jhon02078/enjambre-robots-vision/docs/README.md

# Documentación y material multimedia

Índice de diagramas, informe, fotografías y demostraciones del proyecto.

## Diagramas

- [Arquitectura del sistema](diagramas/Arquitectura%20del%20Sistema.png)
- [Máquina de estados](diagramas/Máquina%20de%20Estados.png)

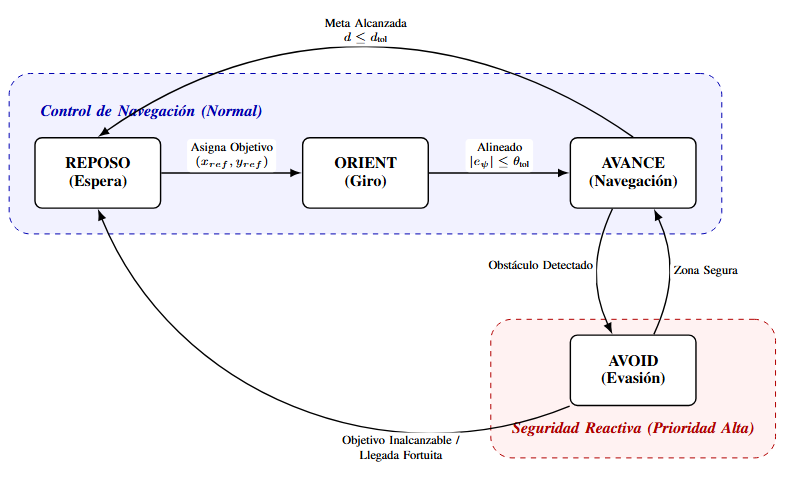
[picture p12: docs/diagramas/Máquina de Estados.png]
Máquina de estados


## Informe

- [Informe del proyecto](informe/Informe.pdf)

El informe conserva el contexto académico y de diseño. Para instrucciones de
ejecución actualizadas use el [README principal](../README.md), porque el
software ha evolucionado después de algunas capturas y documentos.

## Imágenes

### Interfaz

- [Captura de interfaz 1](media/fotos/captura_interfaz_1.jpg)
- [Captura de interfaz 2](media/fotos/captura_interfaz_2.jpg)

### Robots

- [Robot 1](media/fotos/robot_imagen_1.jpg)
- [Robot 2](media/fotos/robot_imagen_2.jpg)
- [Robot 3](media/fotos/robot_imagen_3.jpg)
- [Robot 4](media/fotos/robot_imagen_4.jpg)
- [Robot 5](media/fotos/robot_imagen_5.jpg)

Los números de estas fotografías son un índice de archivo y no necesariamente
coinciden con los IDs ArUco actuales.

## Animación

- [Demostración de funcionamiento](media/gifs/demo_funcionamiento.gif)

Demostración

## Videos

- [Video 1](media/videos/video_funcionamiento_1.mp4)
- [Video 2](media/videos/video_funcionamiento_2.mp4)
- [Video 3](media/videos/video_funcionamiento_3.mp4)
- [Video 4](media/videos/video_funcionamiento_4.mp4)
- [Video 5](media/videos/video_funcionamiento_5.mp4)
- [Video 6](media/videos/video_funcionamiento_6.mp4)
- [Video 7](media/videos/video_funcionamiento_7.mp4)
- [Video 8](media/videos/video_funcionamiento_8.mp4)
- [Video 9](media/videos/video_funcionamiento_9.mp4)

## Mantenimiento

- Use nombres descriptivos para nuevos archivos.
- Comprima videos antes de añadirlos al repositorio.
- No guarde aquí resultados experimentales generados automáticamente.
- Actualice este índice cuando agregue o retire material.
- Evite archivos temporales creados por editores o sincronización en la nube.
