jhon02078/enjambre-robots-vision/docs/media/fotos/captura_interfaz_1.jpg

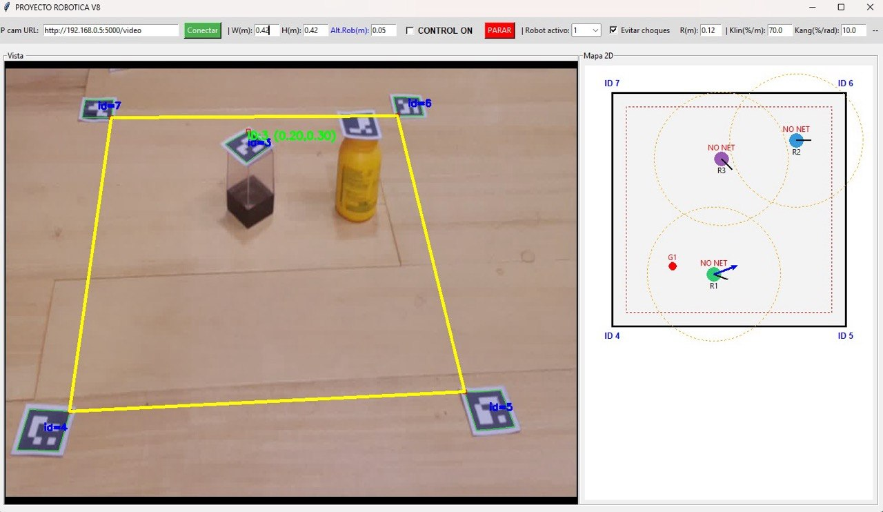
docs/media/fotos/captura_interfaz_1.jpg
