jhon02078/enjambre-robots-vision/docs/media/fotos/robot_imagen_1.jpg

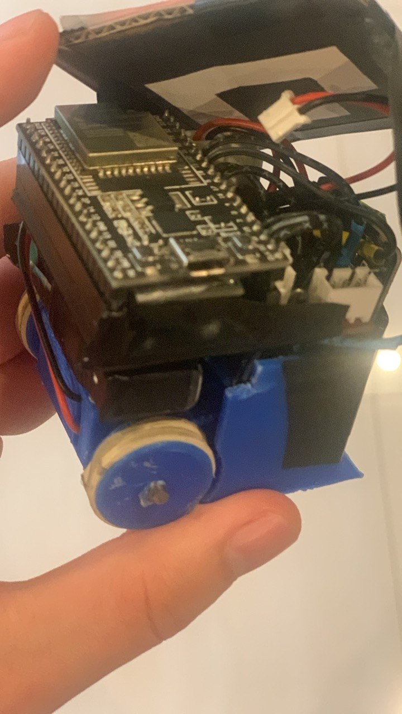
docs/media/fotos/robot_imagen_1.jpg
