jhon02078/enjambre-robots-vision/docs/media/fotos/robot_imagen_2.jpg

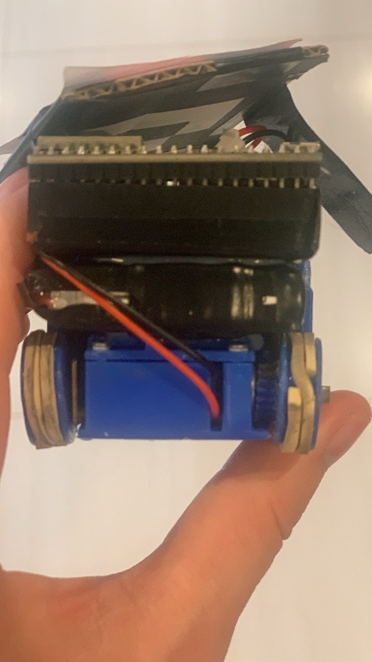
docs/media/fotos/robot_imagen_2.jpg
