jhon02078/enjambre-robots-vision/docs/media/fotos/robot_imagen_3.jpg

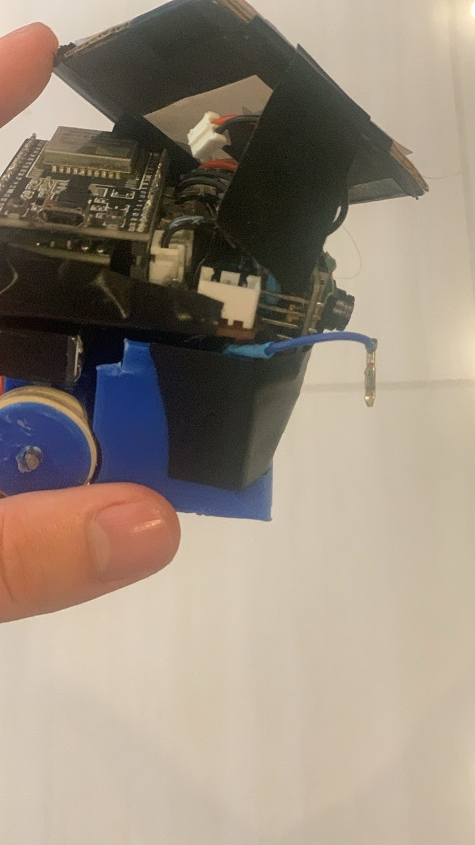
docs/media/fotos/robot_imagen_3.jpg
