jhon02078/enjambre-robots-vision/docs/media/fotos/robot_imagen_4.jpg

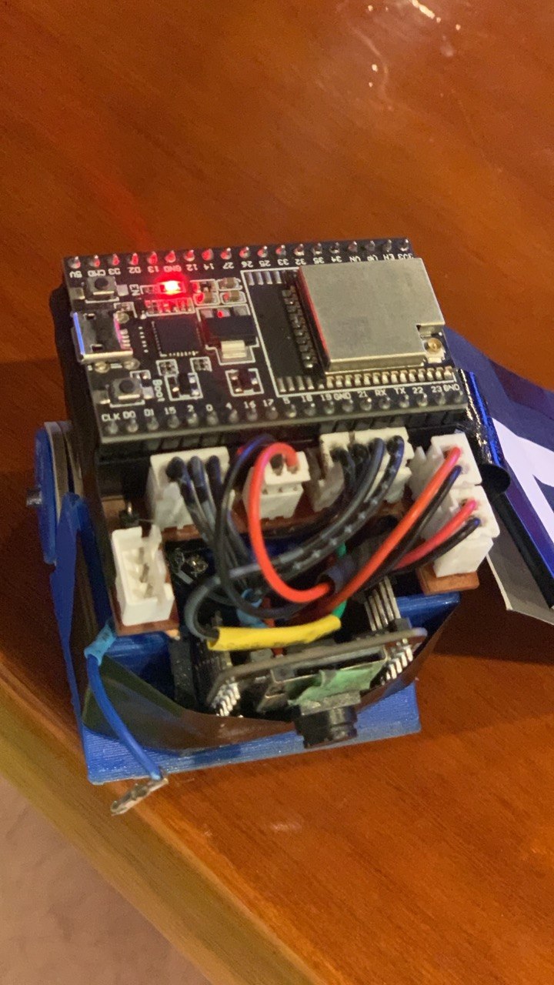
docs/media/fotos/robot_imagen_4.jpg
