jhon02078/enjambre-robots-vision/hardware/pcb/imagenes/pcb_montada.png

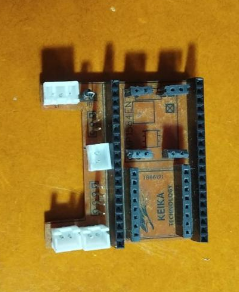
hardware/pcb/imagenes/pcb_montada.png
