jhon02078/enjambre-robots-vision/hardware/cad/Engrane.STL

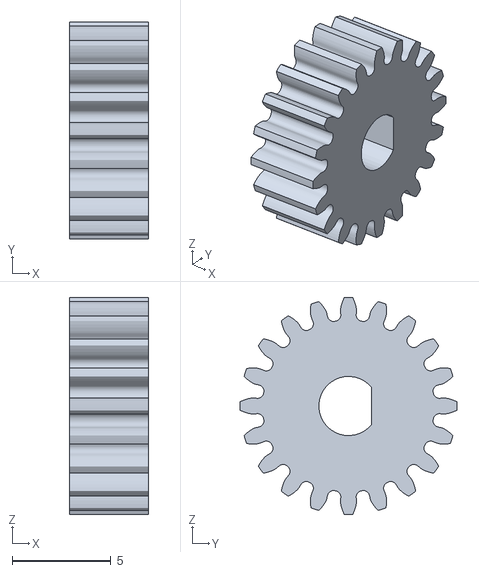
[picture p20: CAD file, 2026-04-19]
hardware/cad/Engrane.STL
4.00 x 11.0 x 11.0
