jhon02078/enjambre-robots-vision/hardware/cad/Llanta.STL

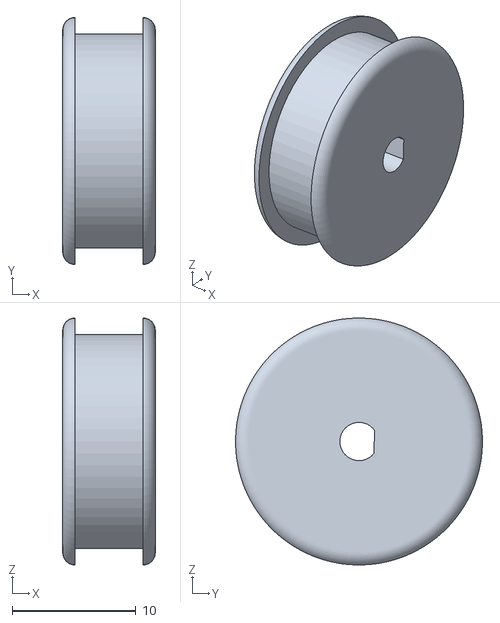
[picture p21: CAD file, 2026-04-19]
hardware/cad/Llanta.STL
7.50 x 20.0 x 20.0
