jhon02078/enjambre-robots-vision/hardware/cad/BaseYTorre.STL

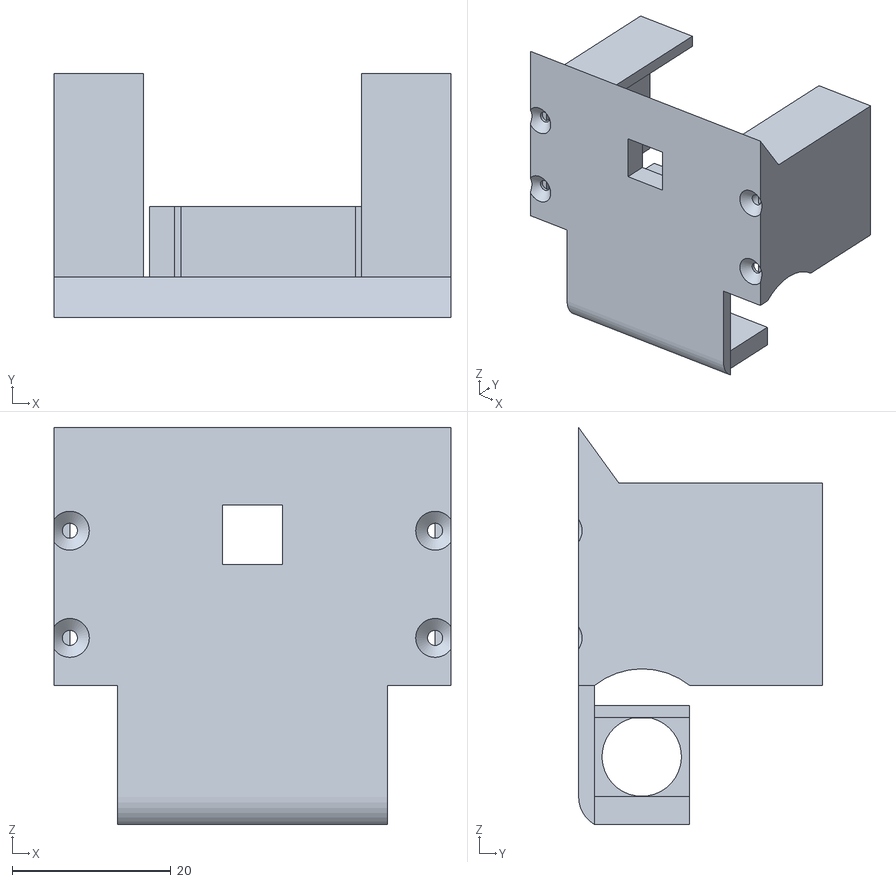
[picture p22: CAD file, 2026-04-19]
hardware/cad/BaseYTorre.STL
50.0 x 30.7 x 50.0
