jhon02078/enjambre-robots-vision/hardware/cad/TapaMotor.STL

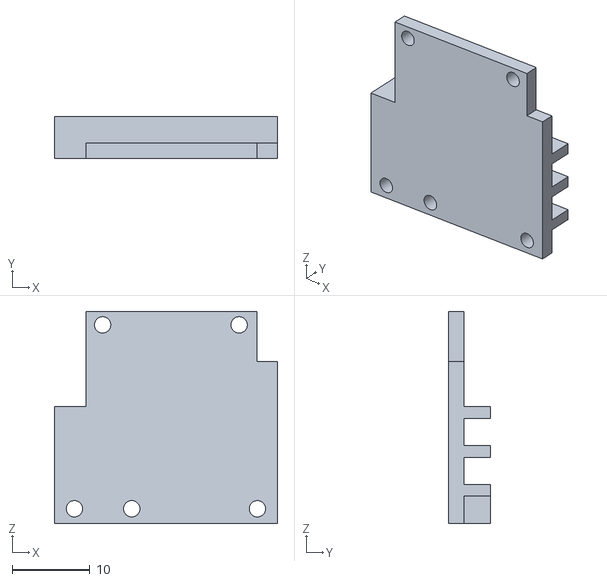
[picture p23: CAD file, 2026-04-19]
hardware/cad/TapaMotor.STL
28.6 x 5.45 x 27.2
