jhon02078/enjambre-robots-vision/hardware/pcb/imagenes/pcb_fabricada.png

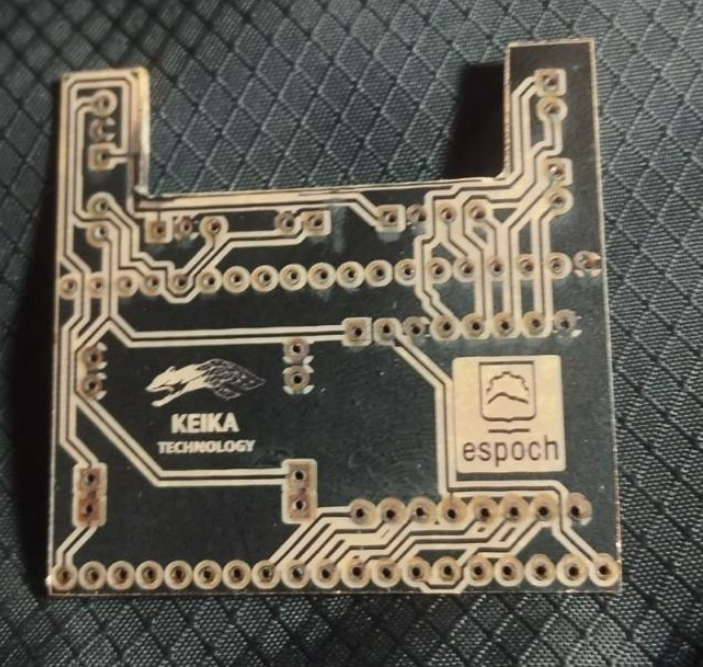
hardware/pcb/imagenes/pcb_fabricada.png
