jhon02078/enjambre-robots-vision/paper/configuracion_publica/intrinsic_validation.csv

timestamp_utc | point | robot_id | physical_x_m | physical_y_m | off_raw_x_m | off_raw_y_m | off_raw_error_m | on_raw_x_m | on_raw_y_m | on_raw_error_m | off_parallax_x_m | off_parallax_y_m | off_parallax_error_m | on_parallax_x_m | on_parallax_y_m | on_parallax_error_m | off_detection_rate_pct | on_detection_rate_pct | off_camera_pose_m | on_camera_pose_m
2026-08-17T20:43:53+00:00 | VIS02_P1_CENTER | 2 | 0.585 | 0.607 | 0.6005092859268188 | 0.6703889966011047 | 0.06525873765293573 | 0.600368082523346 | 0.6764200925827026 | 0.07110082428942284 | 0.597416768574244 | 0.6212414131137666 | 0.018894284567119668 | 0.5968815682409258 | 0.6237664454789384 | 0.02054958291211752 | 100.0 | 92.22222222222223 | [0.5417298450872645, -0.2637585429739723, 1.7106289383162996] | [0.5390367580783869, -0.2498109944414803, 1.5831913346457793]
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
