jhon02078/enjambre-robots-vision/paper/resultados/final_80/all_runs.csv

run_dir | scenario | condition | replicate | controller_mode | requested_delay_ms | duration_s | task_duration_s | task_completed | trial_valid | outcome | stop_reason | minimum_pairwise_distance_m | collision_threshold_episodes | ack_rate_pct | rtt_mean_ms | rtt_p95_ms | actual_delay_mean_ms | actual_delay_p95_ms | vision_processing_mean_ms | frame_wait_mean_ms | homography_valid_rate_pct | detection_rate_pct | path_length_m | distance_rmse_m | heading_mae_deg | control_effort_abs_pct_s | state_transitions | angular_sign_changes | targets_reached
paper/resultados/raw/cruce_2/20260817_205636_cruce_2_proposed_final_r01 | cruce_2 | proposed_final | 1 | apf_fsm | 0.0 | 28.856315699988045 | 27.464995999995153 | 1.0 | 1.0 | success | completed | 0.12743352517238718 | 0.0 | 0.0 | nan | nan | 0.0 | 0.0 | 64.41555347916184 | 17.9508591307398 | 100.0 | 98.26086956521739 | 2.0498846157886463 | 0.5569388890249637 | 28.467928377019565 | 3107.514645397867 | 6.0 | 31.0 | 2.0
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
