jhon02078/enjambre-robots-vision/paper/resultados/final_80/group_statistics.csv

scenario | condition | controller_mode | requested_delay_ms | n | task_duration_s_mean | task_duration_s_std | task_duration_s_ci95_low | task_duration_s_ci95_high | task_completed_mean | task_completed_std | task_completed_ci95_low | task_completed_ci95_high | minimum_pairwise_distance_m_mean | minimum_pairwise_distance_m_std | minimum_pairwise_distance_m_ci95_low | minimum_pairwise_distance_m_ci95_high | collision_threshold_episodes_mean | collision_threshold_episodes_std | collision_threshold_episodes_ci95_low | collision_threshold_episodes_ci95_high | detection_rate_pct_mean | detection_rate_pct_std | detection_rate_pct_ci95_low | detection_rate_pct_ci95_high | path_length_m_mean | path_length_m_std | path_length_m_ci95_low | path_length_m_ci95_high | distance_rmse_m_mean | distance_rmse_m_std | distance_rmse_m_ci95_low | distance_rmse_m_ci95_high | heading_mae_deg_mean | heading_mae_deg_std | heading_mae_deg_ci95_low | heading_mae_deg_ci95_high | control_effort_abs_pct_s_mean | control_effort_abs_pct_s_std | control_effort_abs_pct_s_ci95_low | control_effort_abs_pct_s_ci95_high | state_transitions_mean | state_transitions_std | state_transitions_ci95_low |
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
