jhon02078/enjambre-robots-vision/paper/resultados/final_80/statistical_tests.csv

family | scenario | metric | test | statistic | p_value | n_a | n_b | effect
controller_success | cruce_2 | task_completed | fisher_exact_two_sided | 13.5 | 0.05727554179566563 | 10 | 10 | 0.5
controller_metric | cruce_2 | task_duration_s | mann_whitney_two_sided | 31.0 | 0.050349650349650346 | 9 | 4 | 0.7222222222222222
controller_metric | cruce_2 | minimum_pairwise_distance_m | mann_whitney_two_sided | 54.0 | 0.7913367801006604 | 10 | 10 | 0.08
controller_metric | cruce_2 | heading_mae_deg | mann_whitney_two_sided | 15.0 | 0.009108496398030963 | 10 | 10 | -0.7
controller_metric | cruce_2 | control_effort_abs_pct_s | mann_whitney_two_sided | 82.0 | 0.017257456083119765 | 10 | 10 | 0.64
controller_metric | cruce_2 | angular_sign_changes | mann_whitney_two_sided | 97.5 | 0.00036205898501509104 | 10 | 10 | 0.95
controller_success | cruce_2_perpendicular | task_completed | fisher_exact_two_sided | inf | 1.0 | 10 | 10 | 0.09999999999999998
controller_metric | cruce_2_perpendicular | task_duration_s | mann_whitney_two_sided | 90.0 | 0.0002797002701866865 | 10 | 9 | 1.0
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
