jhon02078/enjambre-robots-vision/paper/resultados/raw/cruce_2/20260817_205636_cruce_2_proposed_final_r01/control.csv

wall_time_iso | t_wall | t_perf | session_elapsed_s | cycle_id | robot_id | state | previous_state | x | y | yaw | pose_age_ms | waypoint_x | waypoint_y | final_goal_x | final_goal_y | distance_error | desired_heading | angle_error | u_att_x | u_att_y | u_rep_x | u_rep_y | u_res_x | u_res_y | repulsion_norm | align_factor | linear_cmd | angular_cmd | left_cmd | right_cmd | controller_mode | avoid_enabled | requested_delay_ms | jitter_ms
2026-08-18T01:56:36.623+00:00 | 1787018196.623529 | 178009.0424996 | 0.2710949000029359 | 108 | 2 | ORIENT | ORIENT | 0.9916435438883312 | 0.612898096502323 | 0.15385420916602616 | 359.63988304138184 | 0.2 | 0.625 | 0.2 | 0.625 | 0.7917360397558918 | 3.1263067833978133 | 2.972452574231787 | -0.9998831748962402 | 0.01528527494519949 | 0.0 | 0.0 | -0.9998831748962402 | 0.01528527494519949 | 0.0 | 0.0 | 0 | 35.0 | -35 | 35 | apf_fsm | 1 | 0.0 | 0.0
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
