jhon02078/enjambre-robots-vision/paper/resultados/raw/cruce_2/20260817_205636_cruce_2_proposed_final_r01/events.csv

wall_time_iso | t_wall | t_perf | session_elapsed_s | event | robot_id | payload_json
2026-08-18T01:56:36.525+00:00 | 1787018196.5251293 | 178008.9405909 | 0.16918619998614304 | session_start |  | {"scenario":"cruce_2","condition":"proposed_final","replicate":1,"controller_mode":"apf_fsm","requested_delay_ms":0.0,"jitter_ms":0.0,"collision_threshold_m":0.12,"homography_mode":"estabilizada","camera_calibration_enabled":true,"camera_calibration_path":"paper/configuracion_publica/camera_calibration.json","localization_alignment_enabled":true,"localization_alignment":{"version":1,"method":"translation_bias_after_parallax","enabled":true,"offset_x_m":-0.01286124999999999,"offset_y_m":-0.011444499999999982,"marker_height_m":0.09,"workspace_width_m":1.2,"workspace_height_m":1.2,"calibration_points":["P_03_03","P_09_03","P_09_09","P_03_09"],"calibration_rmse_m":0.006934283808548666,"calibration_max_error_m":0.011660421596687702,"path":"paper/configuracion_publica/localization_alignment.json"},"parallax_enabled":true,"pose_filter_enabled":true,"robot_ids":[1,2,3,10],"workspace_width_m":1.2,"workspace_height_m":1.2,"workspace_marker_size_m":{"4":0.056,"5":0.056,"6":0.071,"7":0.071},"robot_ma
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
