jhon02078/enjambre-robots-vision/paper/resultados/final_80/controller_comparison.png

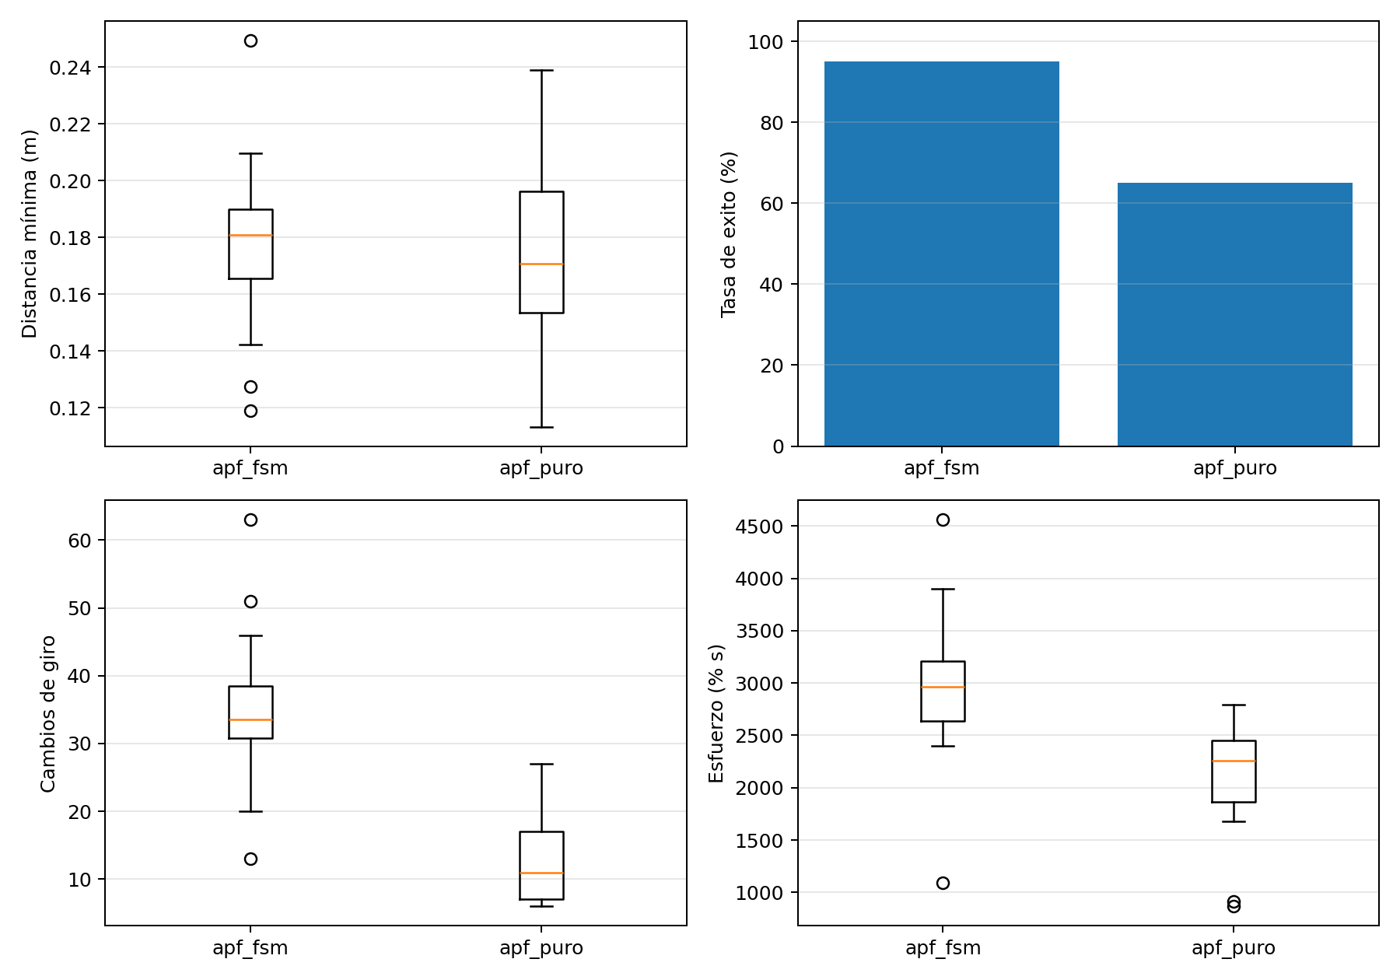
paper/resultados/final_80/controller_comparison.png
