jhon02078/enjambre-robots-vision/paper/resultados/final_80/latency_sweep.png

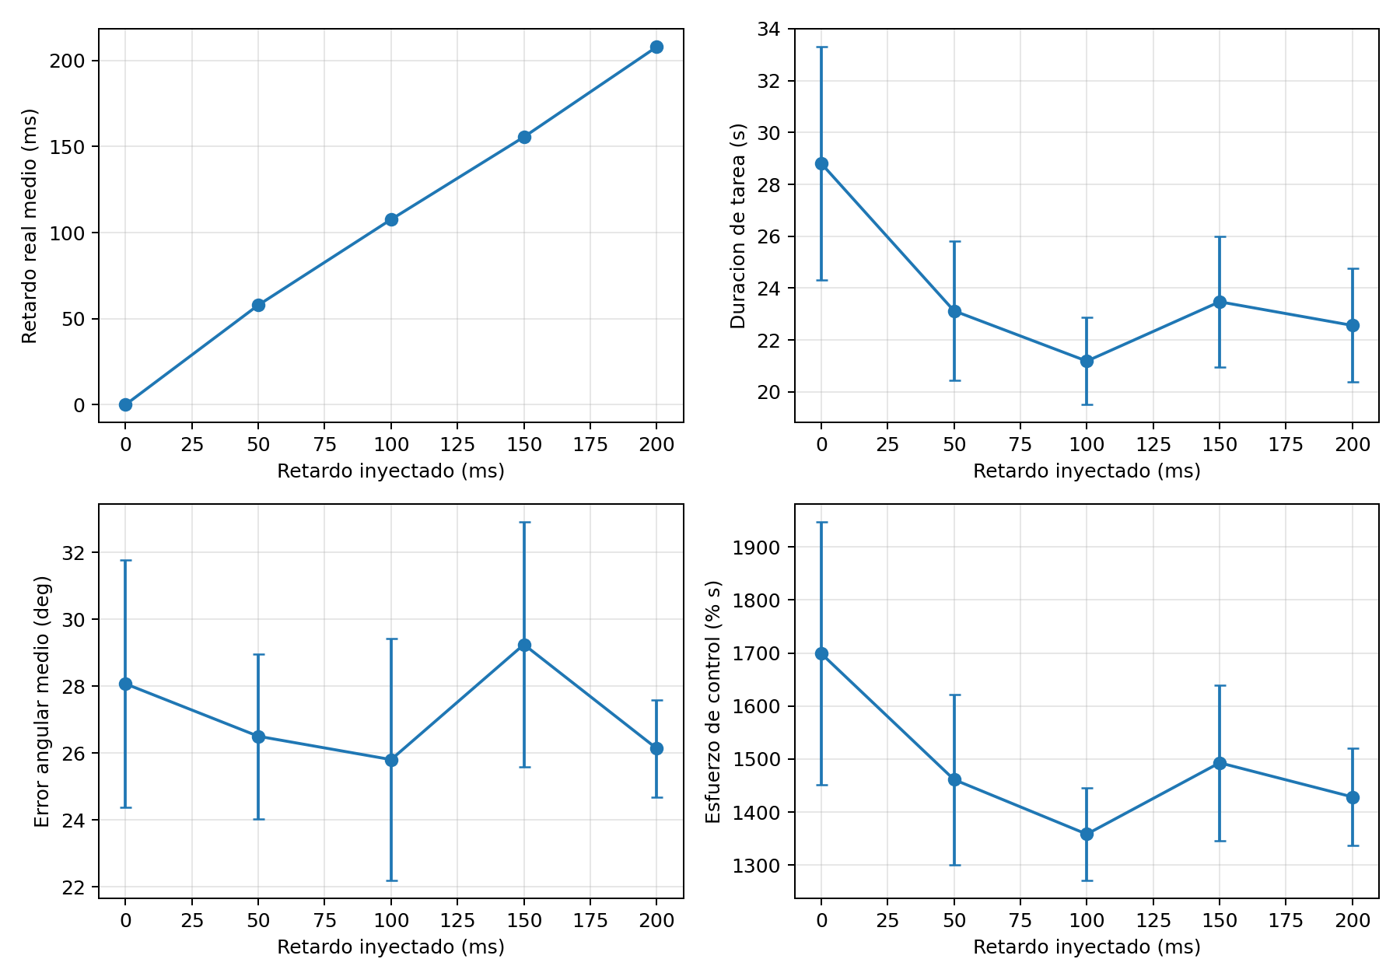
paper/resultados/final_80/latency_sweep.png
