jhon02078/enjambre-robots-vision/paper/resultados/procesados/intrinseca_off_on/intrinsic_errors.png

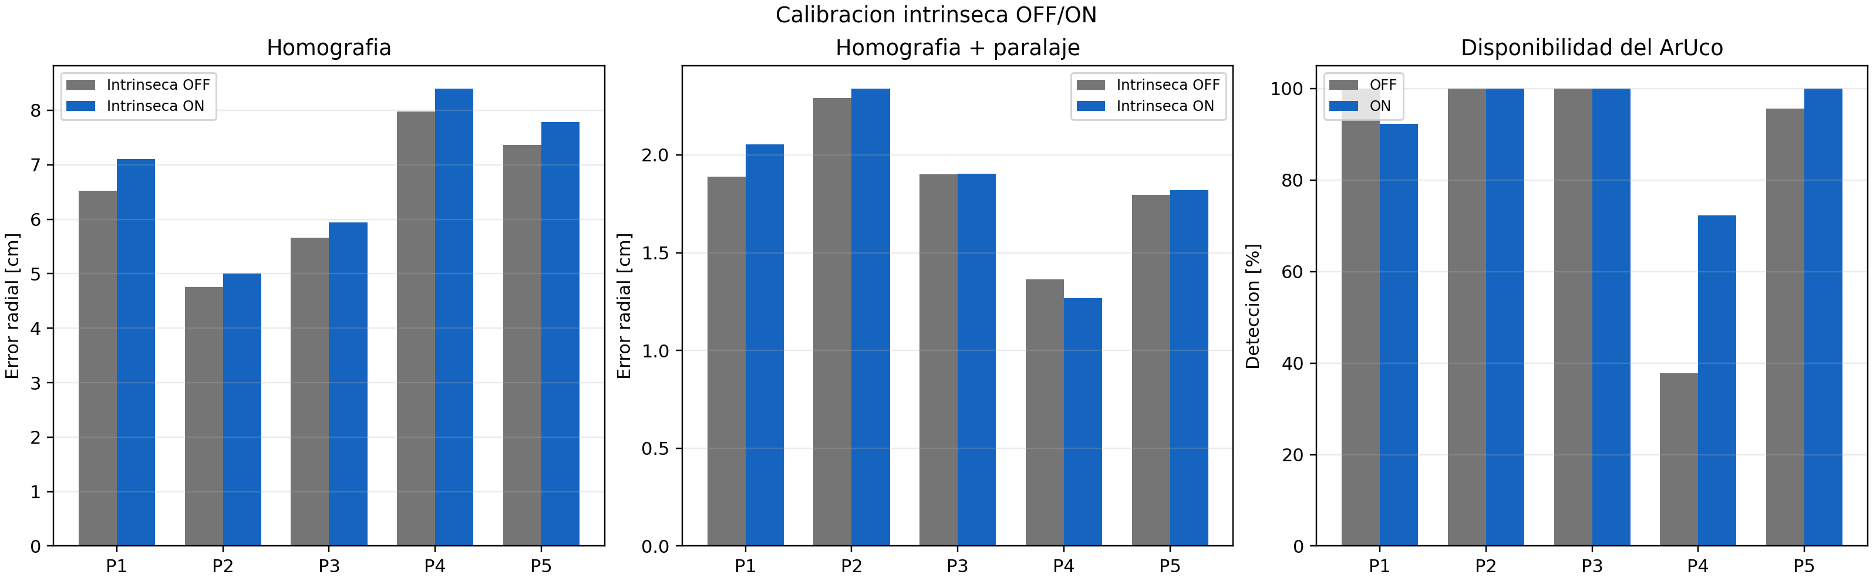
paper/resultados/procesados/intrinseca_off_on/intrinsic_errors.png
