jhon02078/enjambre-robots-vision/paper/resultados/procesados/localizacion_grid/localization_errors.png

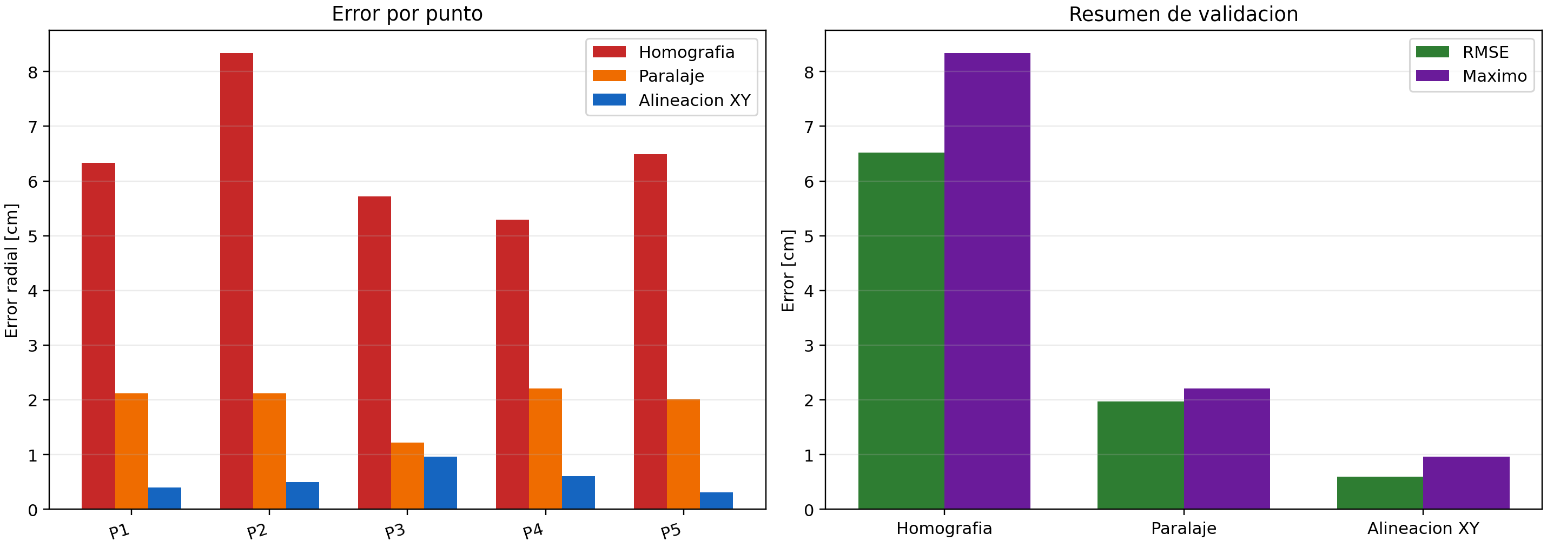
paper/resultados/procesados/localizacion_grid/localization_errors.png
