jhon02078/enjambre-robots-vision/paper/resultados/raw/calibracion/images_tilted/calib_008.png

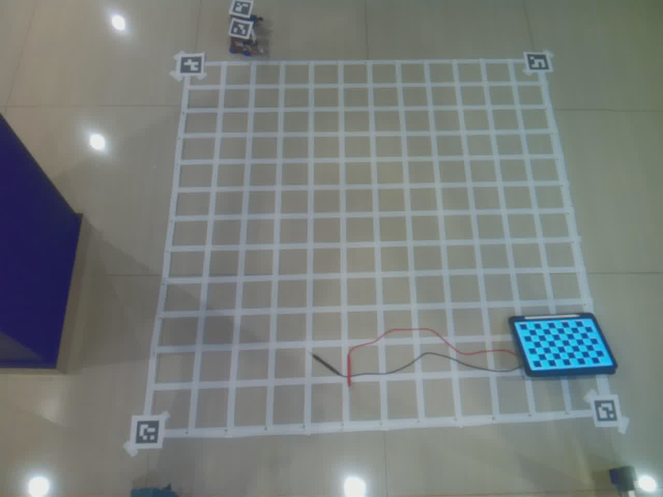
paper/resultados/raw/calibracion/images_tilted/calib_008.png
