jhon02078/enjambre-robots-vision/paper/resultados/raw/calibracion/images_tilted/calib_015.png

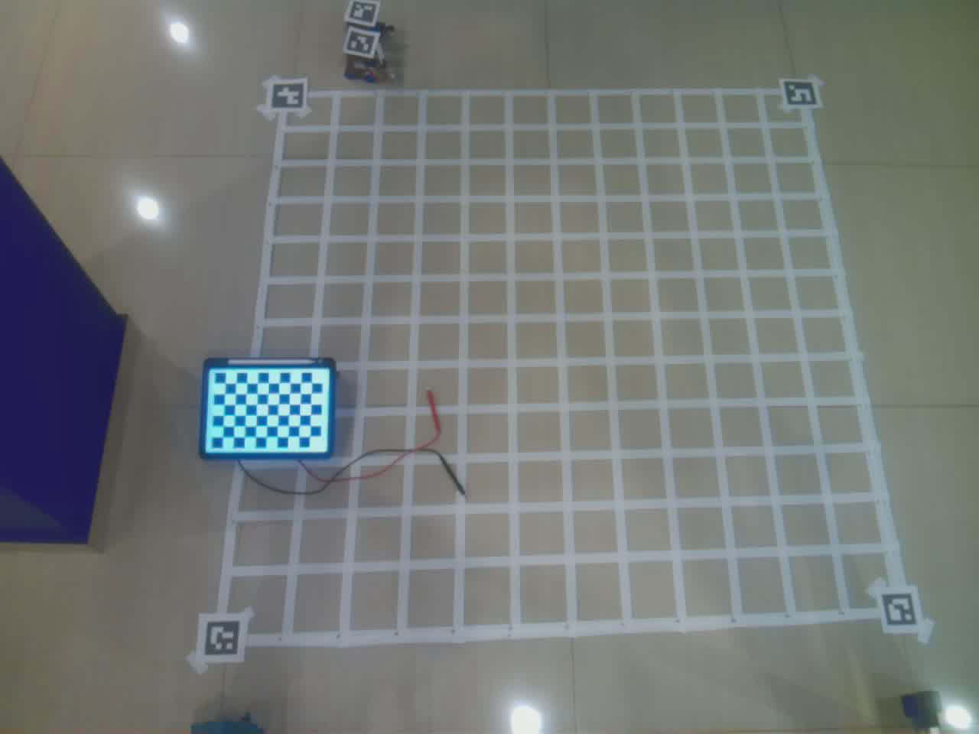
paper/resultados/raw/calibracion/images_tilted/calib_015.png
