jhon02078/enjambre-robots-vision/(list of files, drawings)

Other design files:
hardware/pcb/source/SCH_Minisumo-camara_2026-01-12.json
