jhon02078/enjambre-robots-vision/(commit log)

2026-04-19 Adicion de evidencia de funcionamiento
    [BaseYTorre.STL, Engrane.STL, Llanta.STL, SCH_Minisumo-camara_2026-01-12.json, TapaMotor.STL]
2026-04-19 Actualiza README.md para incluir a Jean Carlos Meneses como autor y agrega sección de evidencia visual del sistema. Elimina nota sobre archivos futuros en README.md de PCB y añade un nuevo GIF demost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
2026-04-19 Actualiza README.md: corrige enlace de imagen y elimina secciones obsoletas sobre la estructura del repositorio y validación visual.
2026-04-19 Elimina recursos sugeridos obsoletos en la sección de evidencia visual del README.md
2026-04-19 Refactor: Limpieza de comentarios y ajustes en la configuración de pines en los archivos de control de robots
2026-05-20 Se realizaron múltiples integraciones en pc_servidor_vision.py enfocadas en la evasión de obstáculos, estabilidad de red, persistencia de datos y suavizado de localización:
    Navegación y Gestión de Paredes:
    - Se añade la funcionalidad para dibujar, editar, guardar y cargar paredes en el mapa 2D (almacenadas en `pc/paredes.json`).
    - Se implementa planificación de trayectorias usando A* con un margen de seguridad (`Clear(m)`) y repulsión local como capa extra de protección.
    - Se configura el control por clics: izquierdo para trazar paredes, derecho para asignar objetivo y central para limpiar la ruta actual.
    - Se integra el parámetro en vivo `Campo(m)`, que controla tanto la zona de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
2026-06-01 Añade la herramienta de diagnóstico de motores UDP con interfaz gráfica y control de movimiento
2026-06-02 Codigo para operar robots modificados para el riotronic
2026-06-04 Añadir aplicación de identificación y pruebas sintéticas
    - Implementada la aplicación principal de identificación de modelos de robot usando visión por computadora en `app_identificacion.py`.
    - Añadida la suite de pruebas sintéticas en `test_synthetic_identificacion.py` para validar el ajuste de modelos y recomendaciones PID.
    - Actualizado `requirements.txt` para incluir las dependencias necesarias de la nueva aplicación.
2026-06-04 Mejorar ver_resultados.py con interfaz Tkinter
    - Añadida interfaz gráfica con Tkinter para `ver_resultados.py`.
    - Nuevas funciones: selector de robot, selector de corrida disponible, botón Elegir carpeta, botón Regenerar PNG, botón Abrir carpeta.
    - Pestaña Resumen/modelo: incluye modelo diferencial completo, ecuaciones Gv(s) y Gw(s), parámetros K, tau, delay, mse, controlador calculado y valores compatibles con `pc_servidor_vision.py`.
    - Pestaña Bode lineal: comparación medido vs modelo.
    - Pestaña Bode angular: comparación medido vs modelo.
    - Pestaña Series temporales: comandos, velocidad lineal y velocidad angular.
2026-06-04 Ajustar uso de PID identificado en pc_servidor_vision.py
    - El problema no era el modelo identificado, sino dónde se aplicaban las constantes.
    - Los modelos identificados son de tipo comando PWM (%) -> velocidad lineal/angular, pero el lazo actual en `pc_servidor_vision.py` es de posición con navegación, evasión, saturación y lógica de alineación.
    - Se usaban las constantes como si fueran error de posición/ángulo -> PWM, lo que saturaba fácilmente (ej. Klin = 228 %/m).
    - Corregido para que el comportamiento por defecto vuelva al esquema estable anterior: `USE_IDENTIFIED_ROBOT_PID = False`.
    - Las constantes identificadas se mantienen en `IDENTIFIED_PID_GAINS`, pero no se activan auto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
2026-06-05 Actualizar README y mejorar funciones de identificación de modelos para incluir soporte de robots adicionales y ajustes en el modelo de transferencia.
2026-07-29 feat(vision): añade coreografía multirrobot y actualiza documentación
    - incorpora coreografía con formaciones cuadrado, diamante, intercambio, fila y órbita
    - integra la coreografía con la planificación de rutas y la parada general
    - permite iniciar y detener la secuencia desde la interfaz
    - documenta detalladamente PC, Raspberry Pi, ESP32, hardware y PCB
    - amplía la guía de identificación, ajuste de modelos y control PID
    - actualiza arquitectura, protocolos, IDs ArUco y procedimientos de diagnóstico
2026-08-16 fix(camera): corrige el servidor Raspberry y actualiza la conexión por mDNS
    - corrige el shebang y el punto de entrada de raspberry_camara.py
    - cambia la transmisión a 1280x960 para conservar el campo de visión 4:3
    - usa raspberry-5.local como dirección predeterminada de la cámara
    - actualiza las aplicaciones de control e identificación
    - sincroniza la documentación con la nueva configuración
    [raspberry_camara.py]
2026-09-08 Actualizacion para paper
    [all_runs.csv, control.csv, errors_by_point.csv, events.csv, frames.csv, group_statistics.csv, intrinsic_validation.csv, latency_fidelity.csv]
